alvarop/test_hub/hw/hub/test_hub.kicad_pcb

## KiCad design hw/hub/test_hub.kicad_pcb (2018-01-09)

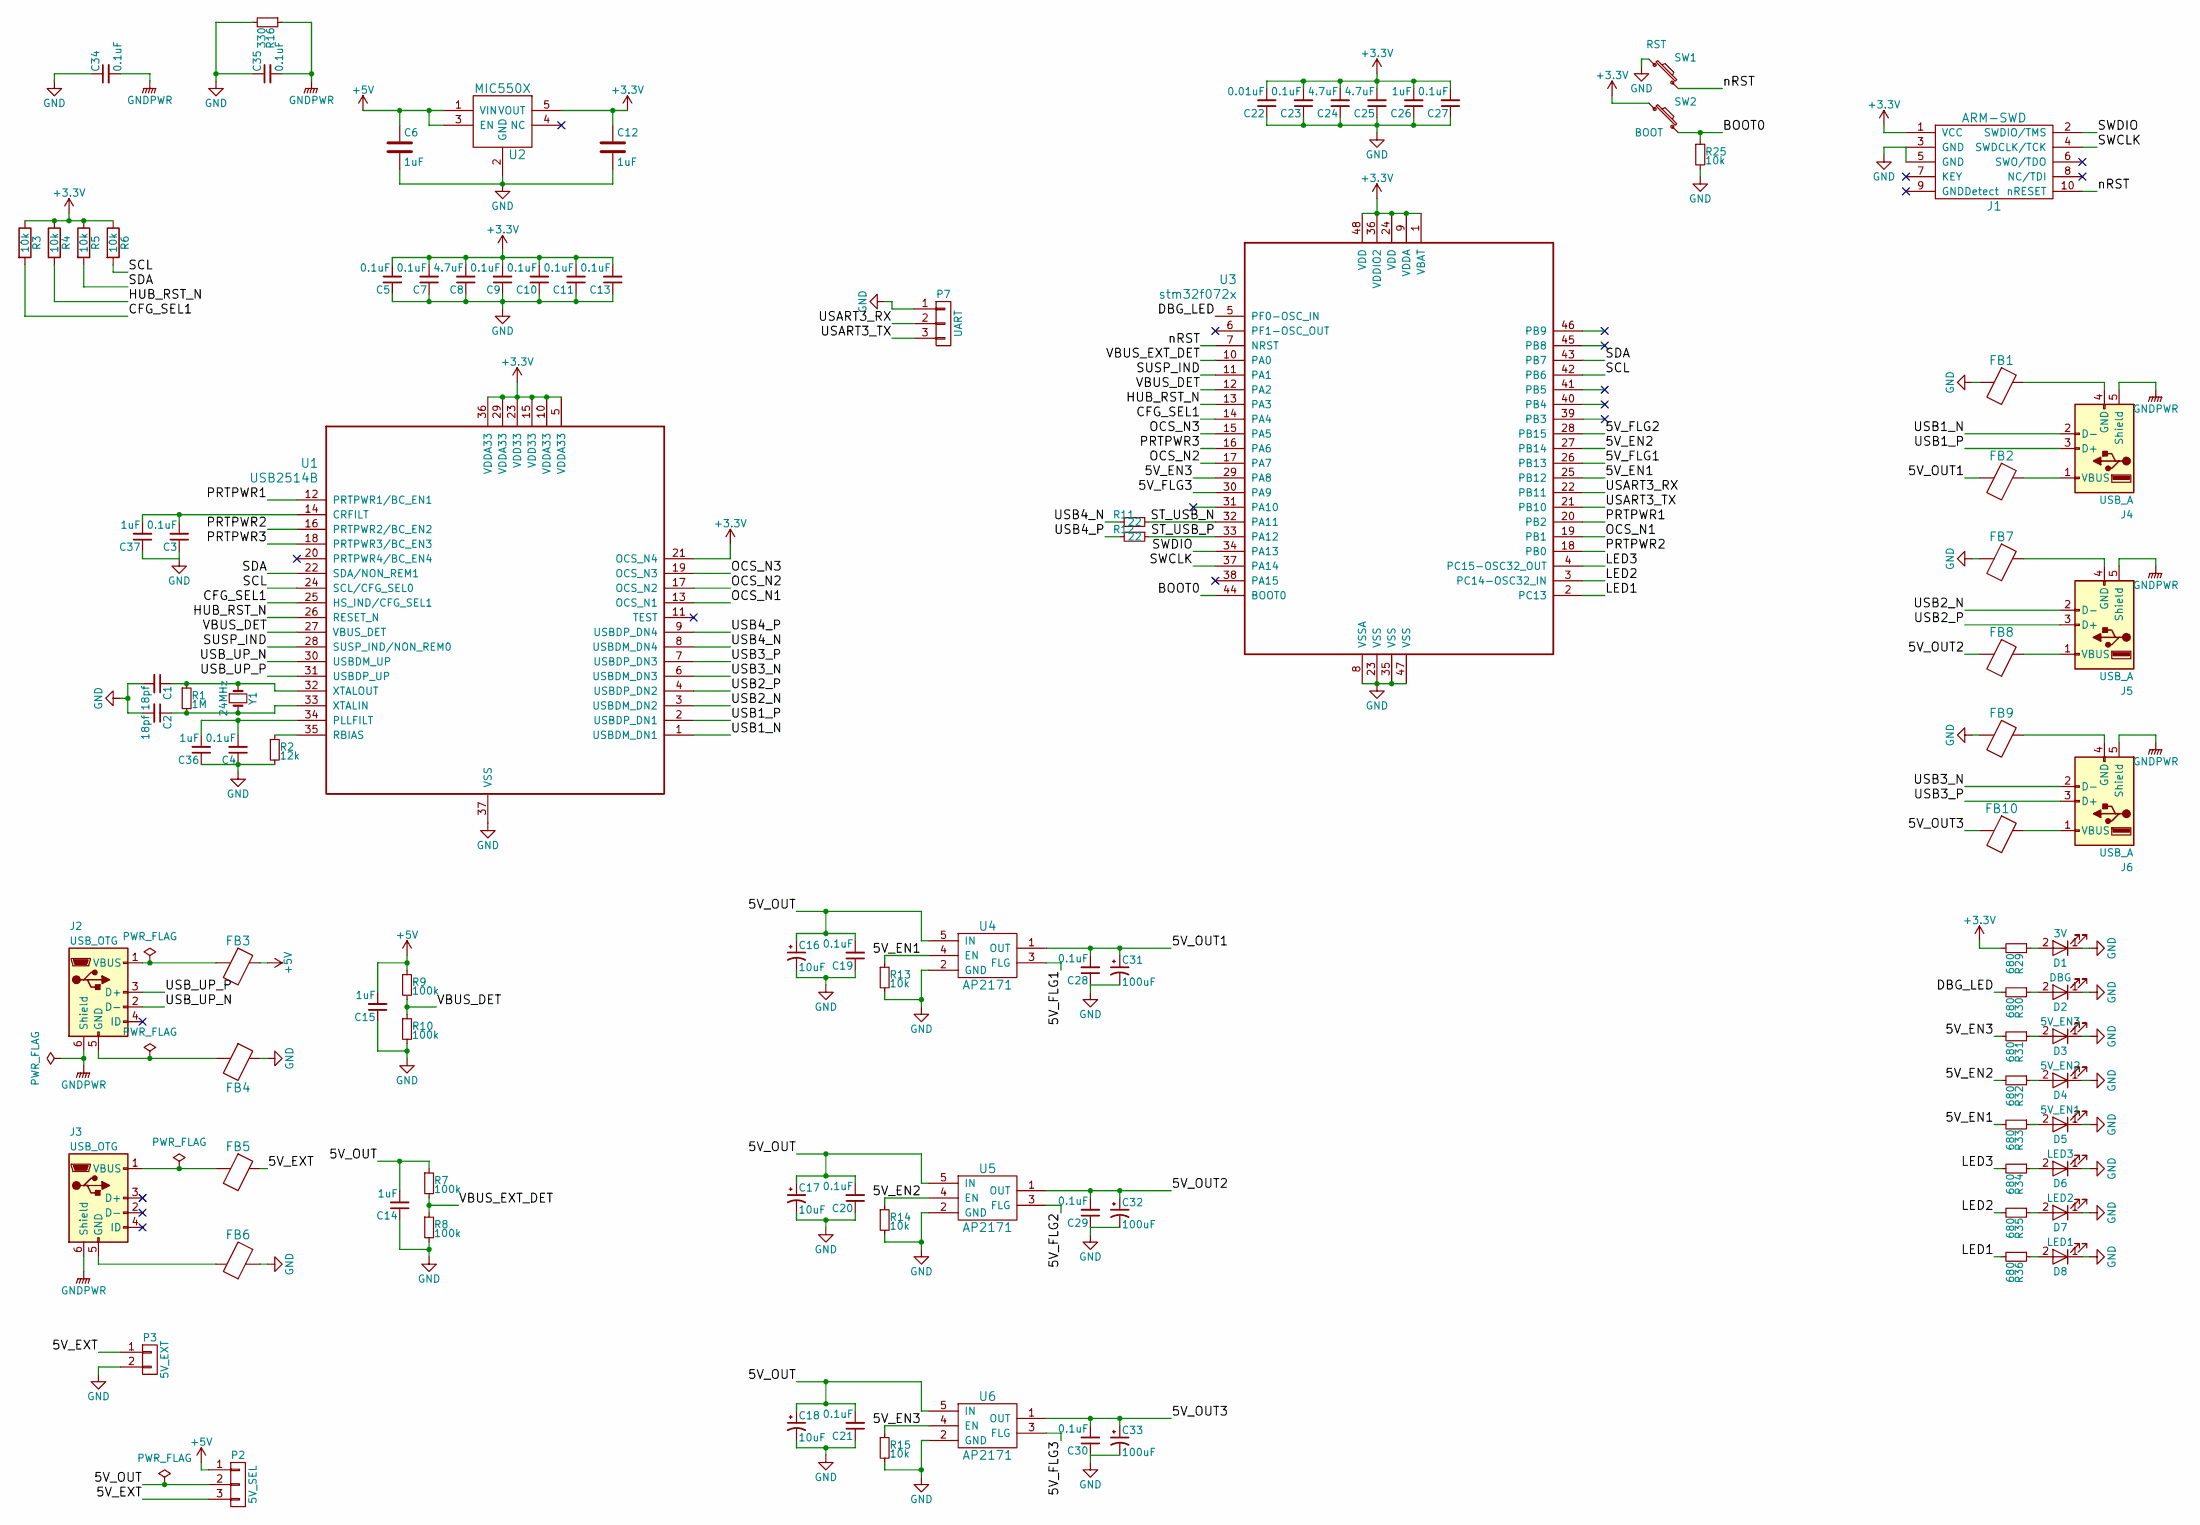
[picture p1: schematic test_hub.sch, Test Hub]

Parts:
C1, C2: 18pf; C_0603; MPN CL10C180JB8NNNC
C3, C4, C5, C7, C9, C10, C11, C13, C19, C20, C21, C23, C27, C28, C29, C30, C34, C35: 0.1uF; C_0603; MPN CC0603ZRY5V9BB104
C6, C12, C14, C15, C26, C36, C37: 1uF; C_0603; MPN GRM188R61C105KA93D
C8, C24, C25: 4.7uF; C_0603; MPN CL10B475KQ8NQNC
C16, C17, C18: 10uF; c_elec_4x5.3; MPN UWX1C100MCL1GB
C22: 0.01uF; C_0603; MPN CL21B103KBANNNC
C31, C32, C33: 100uF; c_elec_6.3x5.7; MPN UWR1A101MCL1GB
D1: 3V; LED_0805; MPN LG R971-KN-1
D2: DBG; LED_0805; MPN LG R971-KN-1
D3: 5V_EN3; LED_0805; MPN LG R971-KN-1
D4: 5V_EN2; LED_0805; MPN LG R971-KN-1
D5: 5V_EN1; LED_0805; MPN LG R971-KN-1
D6: LED3; LED_0805; MPN LG R971-KN-1
D7: LED2; LED_0805; MPN LG R971-KN-1
D8: LED1; LED_0805; MPN LG R971-KN-1
FB1, FB2, FB3, FB4, FB5, FB6, FB7, FB8, FB9, FB10: Ferrite_Bead; R_0603; MPN CIS10P221NC
J1: ARM-SWD; ARM_SWD_SMD; MPN 20021121-00010C4LF
J2, J3: USB_OTG; USB_MICRO_B; MPN 629105150521
J4, J5, J6: USB_A; 292303-1; MPN 292303-1
P2: 5V_SEL; Pin_Header_Straight_1x03
P3: 5V_EXT; Pin_Header_Straight_1x02
P7: UART; Pin_Header_Straight_1x03
R1: 1M; R_0603; MPN ERJ-3GEYJ105V
R2: 12k; R_0603; MPN ERJ-3EKF1202V
R3, R4, R5, R6, R13, R14, R15, R25: 10k; R_0603; MPN RC0603FR-0710KL
R7, R8, R9, R10: 100k; R_0603; MPN ERJ-3GEYJ104V
R11, R12: 22; R_0603; MPN RC0603FR-0722RL
R16: 330; R_0603; MPN RC0603JR-07330RL
R29, R30, R31, R32, R33, R34, R35, R36: 680; R_0603; MPN RC0603JR-07680RL
SW1: RST; PTS645SM43SMTR92; MPN PTS645SM43SMTR92
SW2: BOOT; PTS645SM43SMTR92; MPN PTS645SM43SMTR92
U1: USB2514B; SQFN36; MPN USB2514B/M2
U2: MIC550X; SOT-23(M5); MPN MIC5504-3.3YM5-TR
U3: stm32f072x; LQFP48; MPN STM32F072RBT6
U4, U5, U6: AP2171; SOT-25; MPN AP2171WG-7
Y1: 24MHz; HCM49; MPN HCM4924000000ABJT

Connections:
+3V3: C5.2, C7.2, C8.2, C9.2, C10.2, C11.2, C12.1, C13.2, C22.2, C23.2, C24.2, C25.2, C26.2, C27.2, J1.1 (VCC), R3.1, R4.1, R5.1, R6.1, R29.2, SW2.1, U1.5 (VDDA33), U1.10 (VDDA33), U1.15 (VDD33), U1.21 (OCS_N4), U1.23 (VDD33), U1.29 (VDDA33), U1.36 (VDDA33), U2.5 (VOUT), U3.1 (VBAT), U3.9 (VDDA), U3.24 (VDD), U3.36 (VDDIO2), U3.48 (VDD)
+5V: C6.1, C15.2, FB3.2, P2.1, R9.1, U2.1 (VIN), U2.3 (EN)
/5V_EN1: R13.1, R33.2, U3.25 (PB12), U4.4 (EN)
/5V_EN2: R14.1, R32.2, U3.27 (PB14), U5.4 (EN)
/5V_EN3: R15.1, R31.2, U3.29 (PA8), U6.4 (EN)
/5V_EXT: FB5.2, P2.3, P3.1
/5V_FLG1: U3.26 (PB13), U4.3 (FLG)
/5V_FLG2: U3.28 (PB15), U5.3 (FLG)
/5V_FLG3: U3.30 (PA9), U6.3 (FLG)
/5V_OUT: C14.2, C16.1, C17.1, C18.1, C19.2, C20.2, C21.2, P2.2, R7.1, U4.5 (IN), U5.5 (IN), U6.5 (IN)
/5V_OUT1: C28.2, C31.1, FB2.1, U4.1 (OUT)
/5V_OUT2: C29.2, C32.1, FB8.1, U5.1 (OUT)
/5V_OUT3: C30.2, C33.1, FB10.1, U6.1 (OUT)
/BOOT0: R25.1, SW2.2, U3.44 (BOOT0)
/CFG_SEL1: R3.2, U1.25 (HS_IND/CFG_SEL1), U3.14 (PA4)
/DBG_LED: R30.2, U3.5 (PF0-OSC_IN)
/HUB_RST_N: R4.2, U1.26 (RESET_N), U3.13 (PA3)
/LED1: R36.2, U3.2 (PC13)
/LED2: R35.2, U3.3 (PC14-OSC32_IN)
/LED3: R34.2, U3.4 (PC15-OSC32_OUT)
/OCS_N1: U1.13 (OCS_N1), U3.19 (PB1)
/OCS_N2: U1.17 (OCS_N2), U3.17 (PA7)
/OCS_N3: U1.19 (OCS_N3), U3.15 (PA5)
/PRTPWR1: U1.12 (PRTPWR1/BC_EN1), U3.20 (PB2)
/PRTPWR2: U1.16 (PRTPWR2/BC_EN2), U3.18 (PB0)
/PRTPWR3: U1.18 (PRTPWR3/BC_EN3), U3.16 (PA6)
/SCL: R6.2, U1.24 (SCL/CFG_SEL0), U3.42 (PB6)
/SDA: R5.2, U1.22 (SDA/NON_REM1), U3.43 (PB7)
/ST_USB_N: R11.1, U3.32 (PA11)
/ST_USB_P: R12.1, U3.33 (PA12)
/SUSP_IND: U1.28 (SUSP_IND/NON_REM0), U3.11 (PA1)
/SWCLK: J1.4 (SWDCLK/TCK), U3.37 (PA14)
/SWDIO: J1.2 (SWDIO/TMS), U3.34 (PA13)
/USART3_RX: P7.2, U3.22 (PB11)
/USART3_TX: P7.3, U3.21 (PB10)
/USB1_N: J4.2 (D-), U1.1 (USBDM_DN1)
/USB1_P: J4.3 (D+), U1.2 (USBDP_DN1)
/USB2_N: J5.2 (D-), U1.3 (USBDM_DN2)
/USB2_P: J5.3 (D+), U1.4 (USBDP_DN2)
/USB3_N: J6.2 (D-), U1.6 (USBDM_DN3)
/USB3_P: J6.3 (D+), U1.7 (USBDP_DN3)
/USB4_N: R11.2, U1.8 (USBDM_DN4)
/USB4_P: R12.2, U1.9 (USBDP_DN4)
/USB_UP_N: J2.2 (D-), U1.30 (USBDM_UP)
/USB_UP_P: J2.3 (D+), U1.31 (USBDP_UP)
/VBUS_DET: R9.2, R10.1, U1.27 (VBUS_DET), U3.12 (PA2)
/VBUS_EXT_DET: R7.2, R8.1, U3.10 (PA0)
/nRST: J1.10 (nRESET), SW1.2, U3.7 (NRST)
GND: C1.2, C2.2, C3.1, C4.1, C5.1, C6.2, C7.1, C8.1, C9.1, C10.1, C11.1, C12.2, C13.1, C14.1, C15.1, C16.2, C17.2, C18.2, C19.1, C20.1, C21.1, C22.1, C23.1, C24.1, C25.1, C26.1, C27.1, C28.1, C29.1, C30.1, C31.2, C32.2, C33.2, C34.1, C35.1, C36.1, C37.1, D1.1 (K), D2.1 (K), D3.1 (K), D4.1 (K), D5.1 (K), D6.1 (K), D7.1 (K), D8.1 (K), FB1.1, FB4.2, FB6.1, FB7.1, FB9.1, J1.3 (GND), J1.5 (GND), P3.2, P7.1, R2.2, R8.2, R10.2, R13.2, R14.2, R15.2, R16.2, R25.2, SW1.1, U1.37 (VSS), U2.2 (GND), U3.8 (VSSA), U3.23 (VSS), U3.35 (VSS), U3.47 (VSS), U4.2 (GND), U5.2 (GND), U6.2 (GND)
GNDPWR: C34.2, C35.2, J2.6 (Shield), J3.6 (Shield), J4.5 (Shield), J5.5 (Shield), J6.5 (Shield), R16.1
unnamed: C1.1, R1.1, U1.32 (XTALOUT), Y1.1
unnamed: C2.1, R1.2, U1.33 (XTALIN), Y1.2
unnamed: C3.2, C37.2, U1.14 (CRFILT)
unnamed: C4.2, C36.2, U1.34 (PLLFILT)
unnamed: D1.2 (A), R29.1
unnamed: D2.2 (A), R30.1
unnamed: D3.2 (A), R31.1
unnamed: D4.2 (A), R32.1
unnamed: D5.2 (A), R33.1
unnamed: D6.2 (A), R34.1
unnamed: D7.2 (A), R35.1
unnamed: D8.2 (A), R36.1
unnamed: FB1.2, J4.4 (GND)
unnamed: FB2.2, J4.1 (VBUS)
unnamed: FB3.1, J2.1 (VBUS)
unnamed: FB4.1, J2.5 (GND)
unnamed: FB5.1, J3.1 (VBUS)
unnamed: FB6.2, J3.5 (GND)
unnamed: FB7.2, J5.4 (GND)
unnamed: FB8.2, J5.1 (VBUS)
unnamed: FB9.2, J6.4 (GND)
unnamed: FB10.2, J6.1 (VBUS)
unnamed: R2.1, U1.35 (RBIAS)

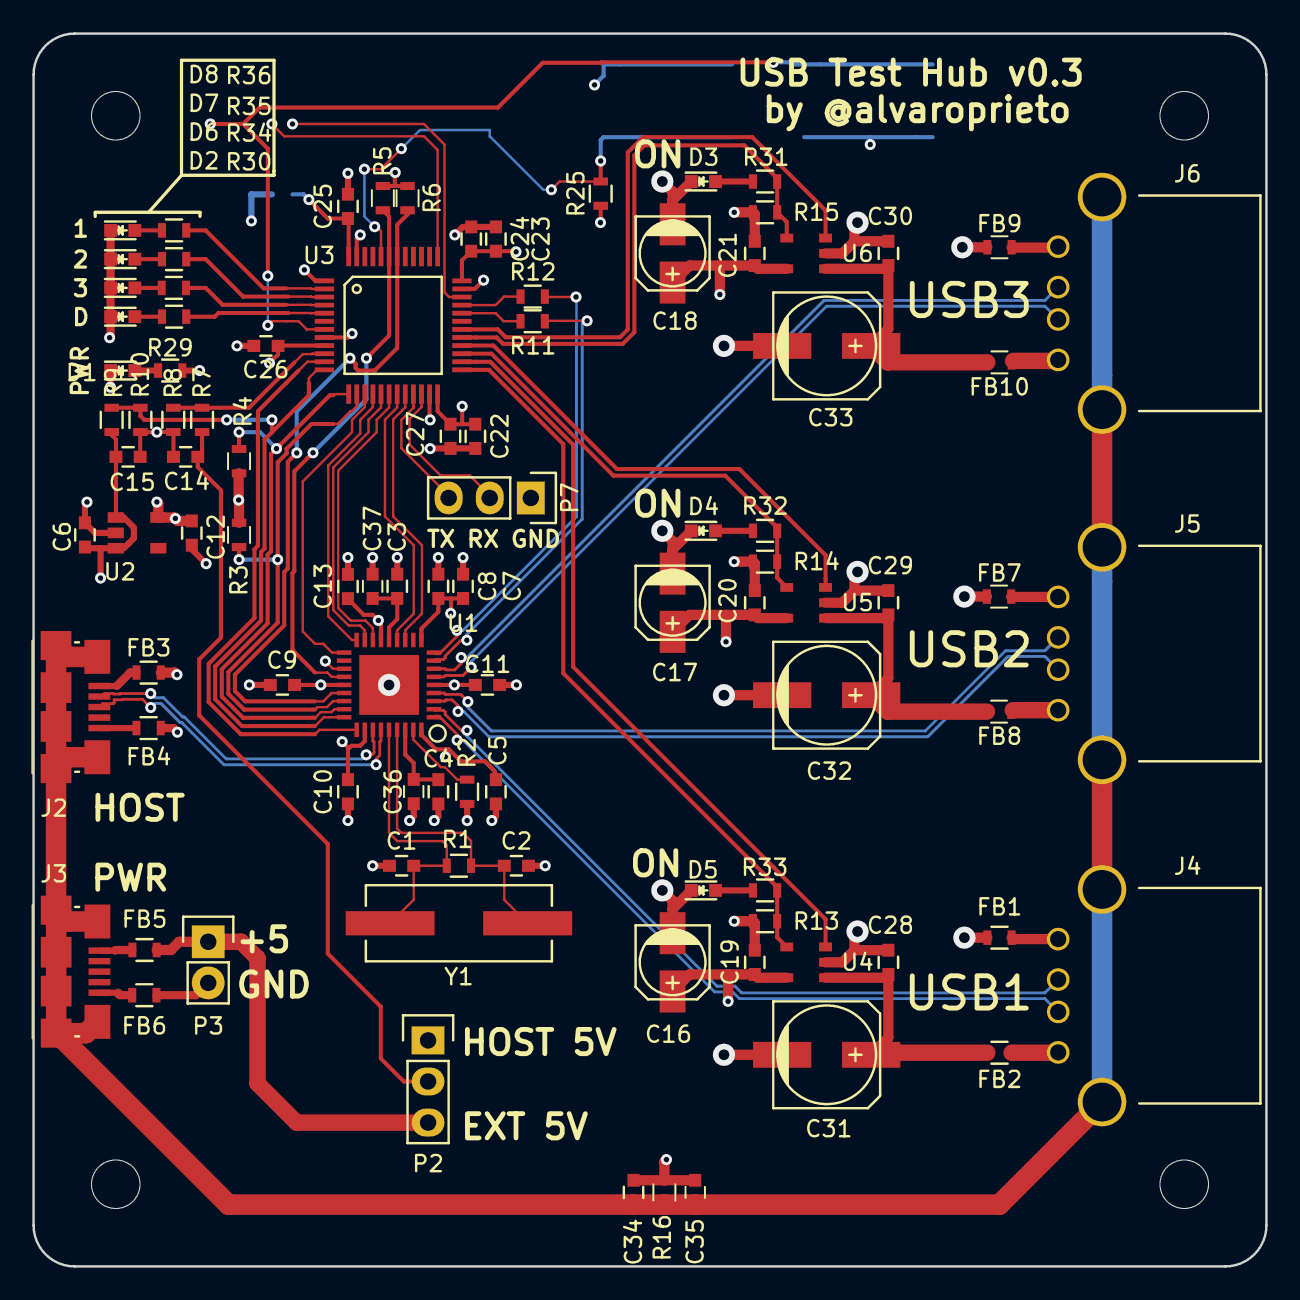
[picture p2: board test_hub.kicad_pcb from above]

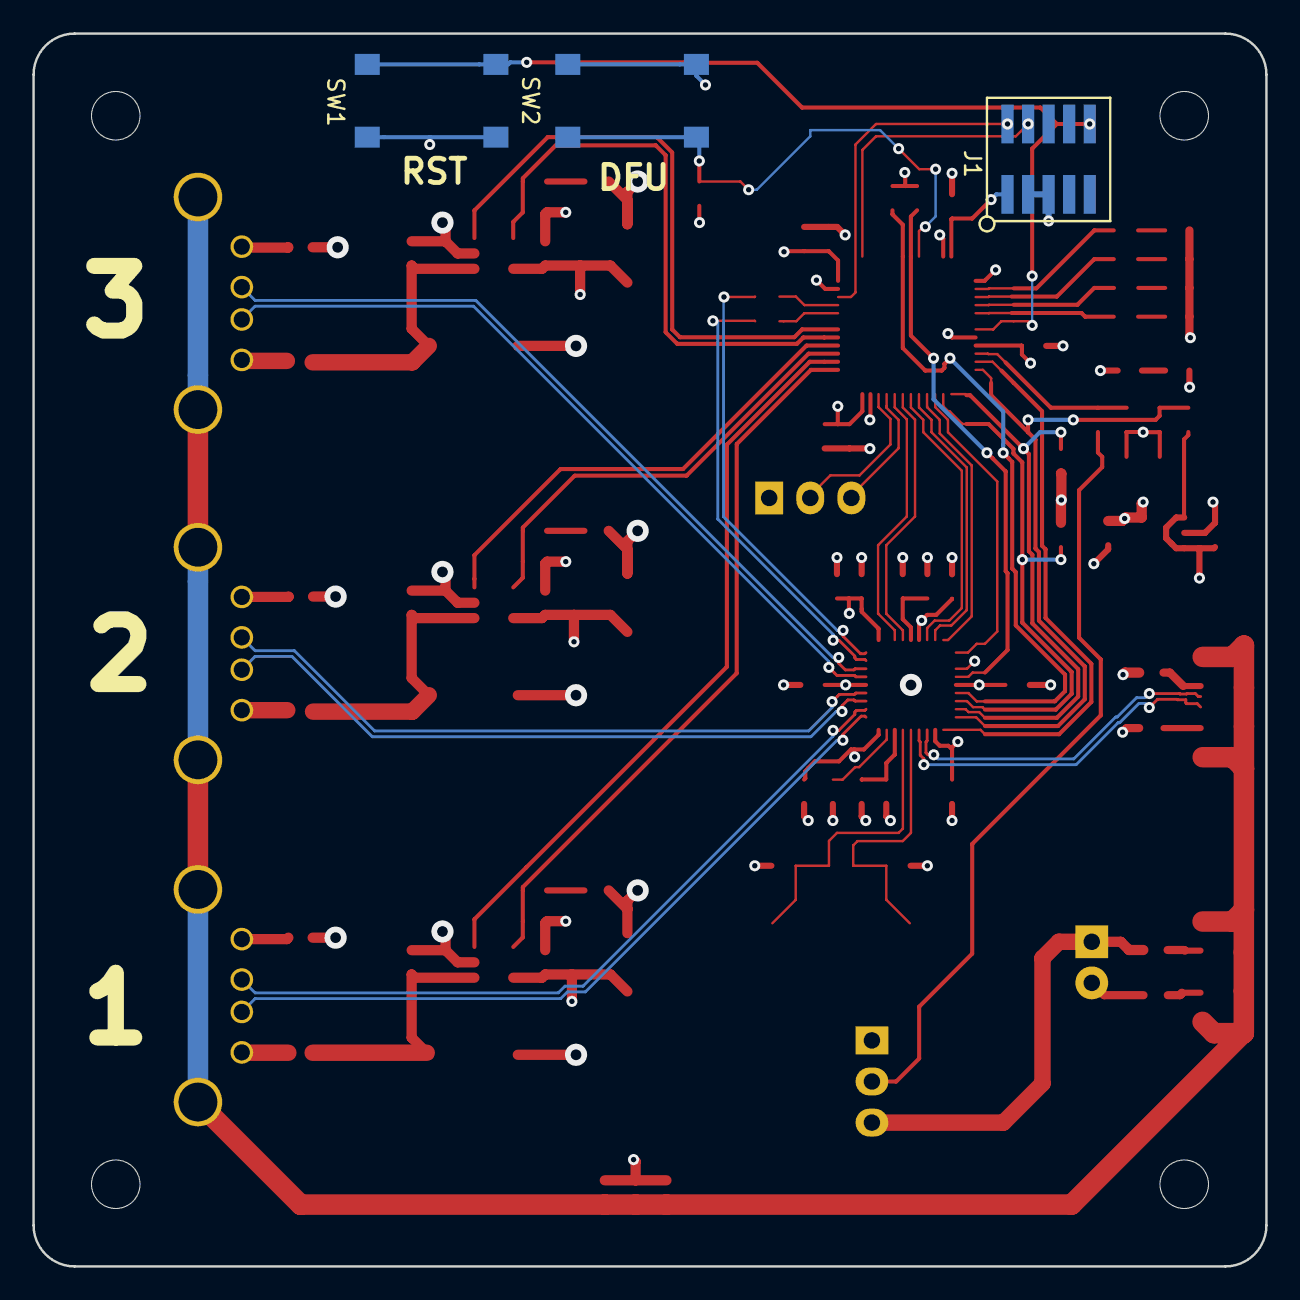
[picture p3: board test_hub.kicad_pcb from below]

Board: 4 copper layers, 76.2 x 76.2 mm, 98 parts (3 on the bottom side), 73 nets.
