alvarop/test_hub/hw/breakout/hub_breakout.kicad_pcb

## KiCad design hw/breakout/hub_breakout.kicad_pcb (2017-03-22)

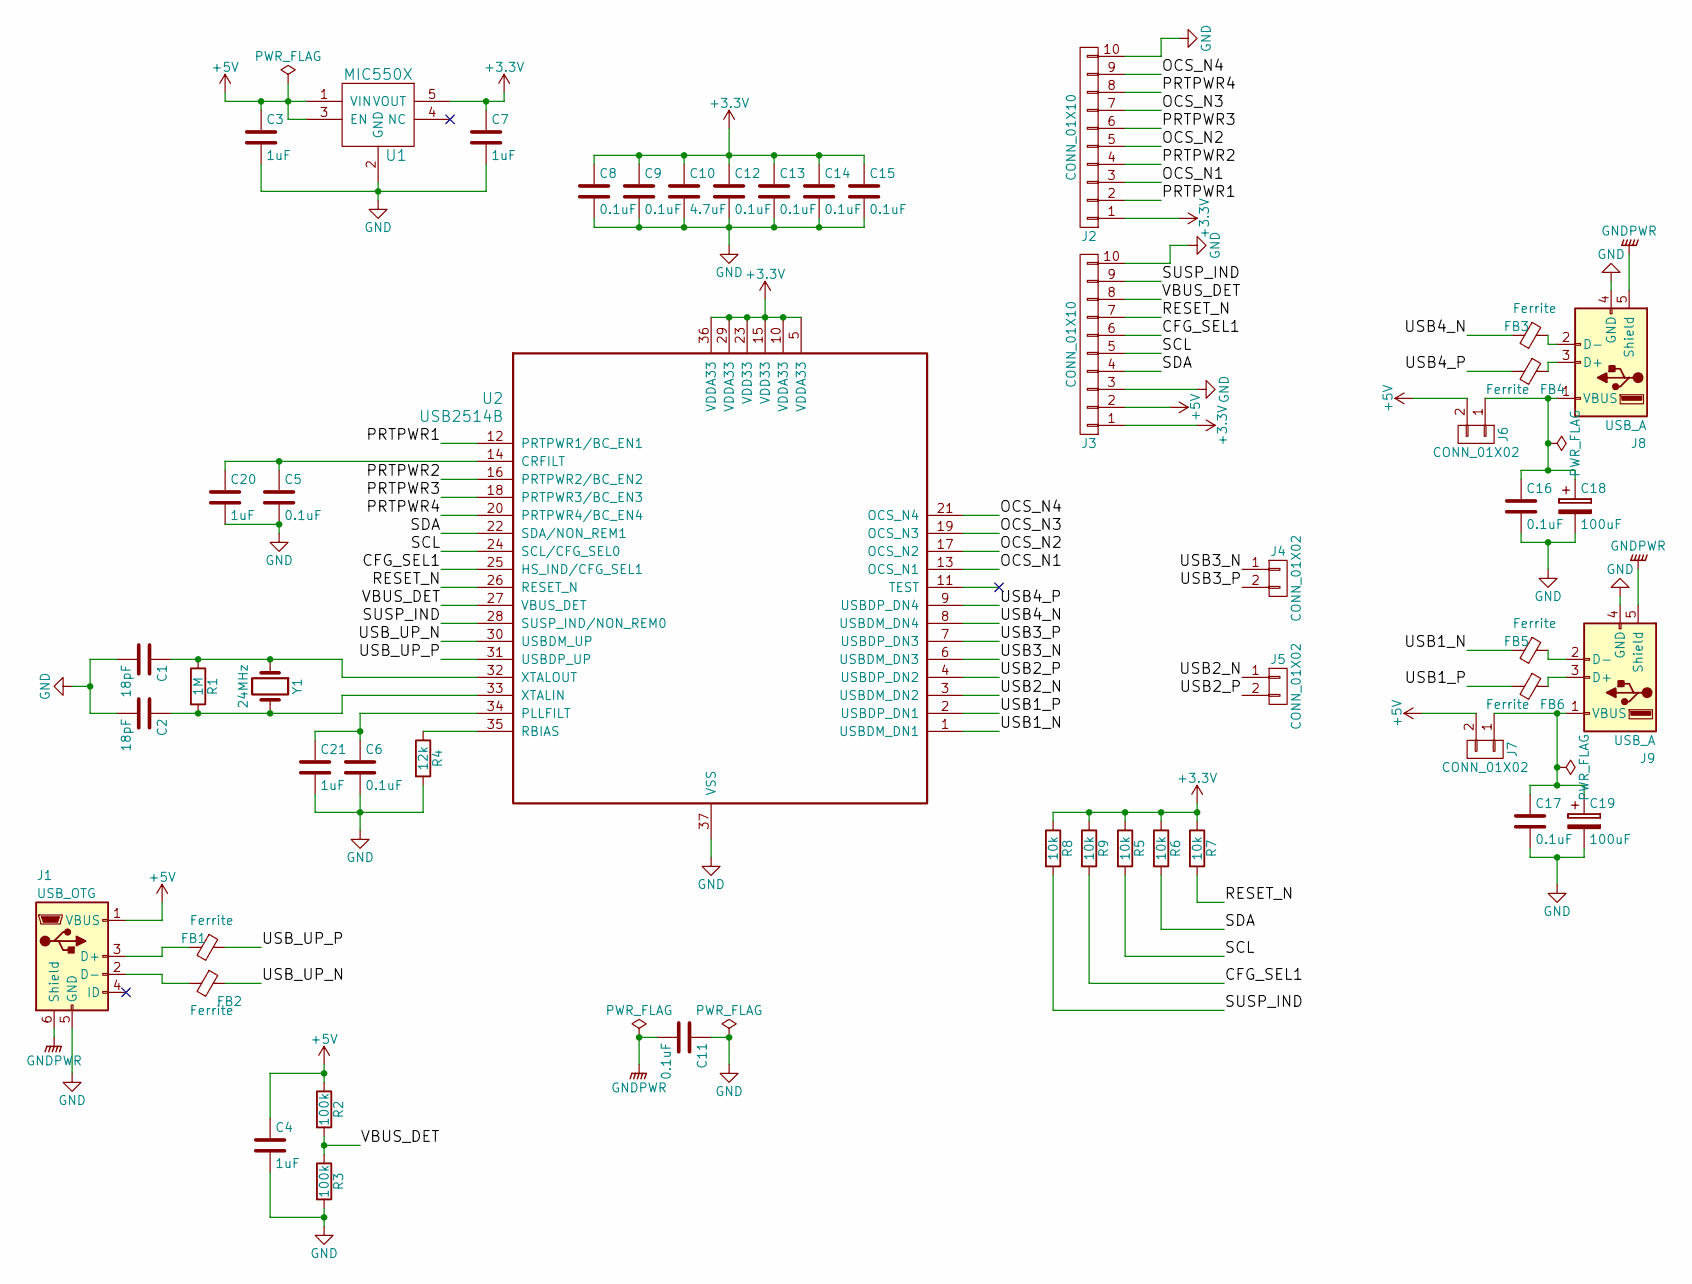
[picture p4: schematic hub_breakout.sch]

Parts:
C1, C2: 18pF; C_0603; MPN CL10C180JB8NNNC
C3, C4, C7, C20, C21: 1uF; C_0603; MPN GRM188R61C105KA93D
C5, C6, C8, C9, C11, C12, C13, C14, C15, C16, C17: 0.1uF; C_0603; MPN CC0603ZRY5V9BB104
C10: 4.7uF; C_0603; MPN CL10B475KQ8NQNC
C18, C19: 100uF; CP_Elec_6.3x5.7; MPN UWR1A101MCL1GB
FB1, FB2, FB3, FB4, FB5, FB6: Ferrite; R_0603; MPN BLM18EG221SN1D
J1: USB_OTG; USB_MICRO_B; MPN 10118193-0001LF
J2, J3: CONN_01X10; Pin_Header_Straight_1x10_Pitch2.54mm
J4, J5, J6, J7: CONN_01X02; Pin_Header_Straight_1x02_Pitch2.54mm
J8, J9: USB_A; 292303-1; MPN 292303-1
R1: 1M; R_0603; MPN ERJ-3GEYJ105V
R2, R3: 100k; R_0603; MPN ERJ-3GEYJ104V
R4: 12k; R_0603; MPN ERJ-3EKF1202V
R5, R6, R7, R8, R9: 10k; R_0603; MPN RC0603FR-0710KL
U1: MIC550X; SOT-23(M5); MPN MIC5504-3.3YM5-TR
U2: USB2514B; SQFN36; MPN USB2514B/M2
Y1: 24MHz; HCM49; MPN HCM4924000000ABJT

Connections:
+3V3: C7.1, C8.1, C9.1, C10.1, C12.1, C13.1, C14.1, C15.1, J2.1, J3.1, R5.1, R6.1, R7.1, R8.1, R9.1, U1.5 (VOUT), U2.5 (VDDA33), U2.10 (VDDA33), U2.15 (VDD33), U2.23 (VDD33), U2.29 (VDDA33), U2.36 (VDDA33)
+5V: C3.1, C4.1, J1.1 (VBUS), J3.2, J6.2, J7.2, R2.1, U1.1 (VIN), U1.3 (EN)
/CFG_SEL1: J3.6, R9.2, U2.25 (HS_IND/CFG_SEL1)
/OCS_N1: J2.3, U2.13 (OCS_N1)
/OCS_N2: J2.5, U2.17 (OCS_N2)
/OCS_N3: J2.7, U2.19 (OCS_N3)
/OCS_N4: J2.9, U2.21 (OCS_N4)
/PRTPWR1: J2.2, U2.12 (PRTPWR1/BC_EN1)
/PRTPWR2: J2.4, U2.16 (PRTPWR2/BC_EN2)
/PRTPWR3: J2.6, U2.18 (PRTPWR3/BC_EN3)
/PRTPWR4: J2.8, U2.20 (PRTPWR4/BC_EN4)
/RESET_N: J3.7, R7.2, U2.26 (RESET_N)
/SCL: J3.5, R5.2, U2.24 (SCL/CFG_SEL0)
/SDA: J3.4, R6.2, U2.22 (SDA/NON_REM1)
/SUSP_IND: J3.9, R8.2, U2.28 (SUSP_IND/NON_REM0)
/USB1_N: FB5.2, U2.1 (USBDM_DN1)
/USB1_P: FB6.2, U2.2 (USBDP_DN1)
/USB2_N: J5.1, U2.3 (USBDM_DN2)
/USB2_P: J5.2, U2.4 (USBDP_DN2)
/USB3_N: J4.1, U2.6 (USBDM_DN3)
/USB3_P: J4.2, U2.7 (USBDP_DN3)
/USB4_N: FB3.2, U2.8 (USBDM_DN4)
/USB4_P: FB4.2, U2.9 (USBDP_DN4)
/USB_UP_N: FB2.1, U2.30 (USBDM_UP)
/USB_UP_P: FB1.1, U2.31 (USBDP_UP)
/VBUS_DET: J3.8, R2.2, R3.1, U2.27 (VBUS_DET)
GND: C1.2, C2.2, C3.2, C4.2, C5.2, C6.2, C7.2, C8.2, C9.2, C10.2, C11.1, C12.2, C13.2, C14.2, C15.2, C16.2, C17.2, C18.2, C19.2, C20.2, C21.2, J1.5 (GND), J2.10, J3.3, J3.10, J8.4 (GND), J9.4 (GND), R3.2, R4.2, U1.2 (GND), U2.37 (VSS)
GNDPWR: C11.2, J1.6 (Shield), J8.5 (Shield), J9.5 (Shield)
unnamed: C1.1, R1.1, U2.32 (XTALOUT), Y1.1
unnamed: C2.1, R1.2, U2.33 (XTALIN), Y1.2
unnamed: C16.1, C18.1, J6.1, J8.1 (VBUS)
unnamed: C17.1, C19.1, J7.1, J9.1 (VBUS)
unnamed: C5.1, C20.1, U2.14 (CRFILT)
unnamed: C6.1, C21.1, U2.34 (PLLFILT)
unnamed: FB1.2, J1.3 (D+)
unnamed: FB2.2, J1.2 (D-)
unnamed: FB3.1, J8.2 (D-)
unnamed: FB4.1, J8.3 (D+)
unnamed: FB5.1, J9.2 (D-)
unnamed: FB6.1, J9.3 (D+)
unnamed: R4.1, U2.35 (RBIAS)

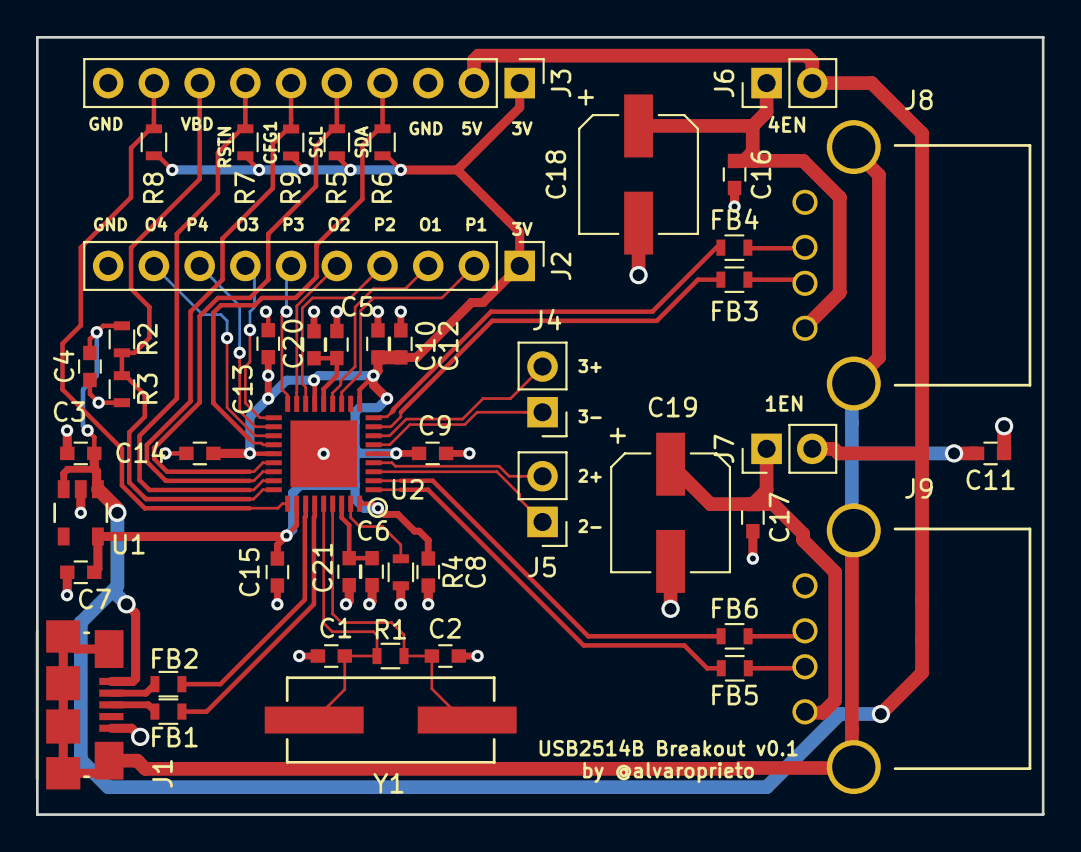
[picture p5: board hub_breakout.kicad_pcb from above]

Board: 2 copper layers, 55.9 x 43.2 mm, 48 parts (0 on the bottom side), 41 nets.
