alvarop/test_hub/fw/board.h

#ifndef __PINS_H__
#define __PINS_H__

#define _LED1_PORT GPIOC
#define _LED1_PIN 13

#define _LED2_PORT GPIOC
#define _LED2_PIN 14

#define _LED3_PORT GPIOC
#define _LED3_PIN 15

#define _DBG_LED_PORT GPIOF
#define _DBG_LED_PIN 0

#define _VBUS_EXT_DET_PORT GPIOA
#define _VBUS_EXT_DET_PIN 1

#define _SUSP_IND_PORT GPIOB
#define _SUSP_IND_PIN 3

#define _VBUS_DET_PORT GPIOA
#define _VBUS_DET_PIN 0

#define _HUB_RST_N_PORT GPIOB
#define _HUB_RST_N_PIN 15

#define _CFG_SEL1_PORT GPIOB
#define _CFG_SEL1_PIN 4

#define _OCS_N3_PORT GPIOA
#define _OCS_N3_PIN 5

#define _PRTPWR3_PORT GPIOA
#define _PRTPWR3_PIN 6

#define _OCS_N2_PORT GPIOA
#define _OCS_N2_PIN 7

#define _PRTPWR2_PORT GPIOB
#define _PRTPWR2_PIN 0

#define _OCS_N1_PORT GPIOB
#define _OCS_N1_PIN 1

#define _PRTPWR1_PORT GPIOB
#define _PRTPWR1_PIN 2

#define _USART3_TX_PORT GPIOB
#define _USART3_TX_PIN 10

#define _USART3_RX_PORT GPIOB
#define _USART3_RX_PIN 11

#define _5V_EN1_PORT GPIOB
#define _5V_EN1_PIN 12

#define _5V_FLG1_PORT GPIOA
#define _5V_FLG1_PIN 8

#define _5V_EN2_PORT GPIOB
#define _5V_EN2_PIN 13

#define _5V_FLG2_PORT GPIOA
#define _5V_FLG2_PIN 9

#define _5V_EN3_PORT GPIOB
#define _5V_EN3_PIN 14

#define _5V_FLG3_PORT GPIOA
#define _5V_FLG3_PIN 10

#define _ST_USB_N_PORT GPIOA
#define _ST_USB_N_PIN 11

#define _ST_USB_P_PORT GPIOA
#define _ST_USB_P_PIN 12

#define _SWDIO_PORT GPIOA
#define _SWDIO_PIN 13

#define _SWCLK_PORT GPIOA
#define _SWCLK_PIN 14

#define _SCL_PORT GPIOB
#define _SCL_PIN 6

#define _SDA_PORT GPIOB
#define _SDA_PIN 7

#define _SNS1_PORT GPIOA
#define _SNS1_PIN 2

#define _SNS2_PORT GPIOA
#define _SNS2_PIN 3

#define _SNS3_PORT GPIOA
#define _SNS3_PIN 4

#endif  // __PINS_H__

// #ifndef __PINS_H__
// #define __PINS_H__

// #define _LED1_PORT GPIOC
// #define _LED1_PIN 13

// #define _LED2_PORT GPIOC
// #define _LED2_PIN 14

// #define _LED3_PORT GPIOC
// #define _LED3_PIN 15

// #define _DBG_LED_PORT GPIOF
// #define _DBG_LED_PIN 0

// #define _VBUS_EXT_DET_PORT GPIOA
// #define _VBUS_EXT_DET_PIN 0

// #define _SUSP_IND_PORT GPIOA
// #define _SUSP_IND_PIN 1

// #define _VBUS_DET_PORT GPIOA
// #define _VBUS_DET_PIN 2

// #define _HUB_RST_N_PORT GPIOA
// #define _HUB_RST_N_PIN 3

// #define _CFG_SEL1_PORT GPIOA
// #define _CFG_SEL1_PIN 4

// #define _OCS_N3_PORT GPIOA
// #define _OCS_N3_PIN 5

// #define _PRTPWR3_PORT GPIOA
// #define _PRTPWR3_PIN 6

// #define _OCS_N2_PORT GPIOA
// #define _OCS_N2_PIN 7

// #define _PRTPWR2_PORT GPIOB
// #define _PRTPWR2_PIN 0

// #define _OCS_N1_PORT GPIOB
// #define _OCS_N1_PIN 1

// #define _PRTPWR1_PORT GPIOB
// #define _PRTPWR1_PIN 2

// #define _USART3_TX_PORT GPIOB
// #define _USART3_TX_PIN 10

// #define _USART3_RX_PORT GPIOB
// #define _USART3_RX_PIN 11

// #define _5V_EN1_PORT GPIOB
// #define _5V_EN1_PIN 12

// #define _5V_FLG1_PORT GPIOB
// #define _5V_FLG1_PIN 13

// #define _5V_EN2_PORT GPIOB
// #define _5V_EN2_PIN 14

// #define _5V_FLG2_PORT GPIOB
// #define _5V_FLG2_PIN 15

// #define _5V_EN3_PORT GPIOA
// #define _5V_EN3_PIN 8

// #define _5V_FLG3_PORT GPIOA
// #define _5V_FLG3_PIN 9

// #define _ST_USB_N_PORT GPIOA
// #define _ST_USB_N_PIN 11

// #define _ST_USB_P_PORT GPIOA
// #define _ST_USB_P_PIN 12

// #define _SWDIO_PORT GPIOA
// #define _SWDIO_PIN 13

// #define _SWCLK_PORT GPIOA
// #define _SWCLK_PIN 14

// #define _SCL_PORT GPIOB
// #define _SCL_PIN 6

// #define _SDA_PORT GPIOB
// #define _SDA_PIN 7

// #endif  // __PINS_H__
