alvarop/test_hub/fw/usb2514b_config.c

#include <stdint.h>

// TODO - put in ram so we can modify it later on the go
const uint8_t hub_cfg[256] = {
    0x24,  // Vendor ID LSB
    0x04,  // Vendor ID MSB
    0x14,  // Product ID LSB
    0x25,  // Product ID MSB
    0xB3,  // Device ID LSB
    0x0B,  // Device ID MSB
    0x9B,  // Configuration Data Byte 1
    0x20,  // Configuration Data Byte 2
    0x02,  // Configuration Data Byte 3
    0x00,  // Non-Removable Devices
    0x00,  // Port Disable (Self)
    0x00,  // Port Disable (Bus)
    0x01,  // Max Power (Self)
    0x32,  // Max Power (Bus)
    0x01,  // Hub Controller Max Current (Self)
    0x32,  // Hub Controller Max Current (Bus)
    0x32,  // Power-on Time
    0x00,  // Language ID High
    0x00,  // Language ID Low
    0x00,  // Manufacturer String Length
    0x00,  // Product String Length
    0x00,  // Serial String Length
    0x00,  // Manufacturer String
    0x00,  //
    0x00,  //
    0x00,  //
    0x00,  //
    0x00,  //
    0x00,  //
    0x00,  //
    0x00,  //
    0x00,  //
    0x00,  //
    0x00,  //
    0x00,  //
    0x00,  //
    0x00,  //
    0x00,  //
    0x00,  //
    0x00,  //
    0x00,  //
    0x00,  //
    0x00,  //
    0x00,  //
    0x00,  //
    0x00,  //
    0x00,  //
    0x00,  //
    0x00,  //
    0x00,  //
    0x00,  //
    0x00,  //
    0x00,  //
    0x00,  //
    0x00,  //
    0x00,  //
    0x00,  //
    0x00,  //
    0x00,  //
    0x00,  //
    0x00,  //
    0x00,  //
    0x00,  //
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
    0x00,  // Product String
    0x00,  //
    0x00,  //
    0x00,  //
    0x00,  //
    0x00,  //
    0x00,  //
    0x00,  //
    0x00,  //
    0x00,  //
    0x00,  //
    0x00,  //
    0x00,  //
    0x00,  //
    0x00,  //
    0x00,  //
    0x00,  //
    0x00,  //
    0x00,  //
    0x00,  //
    0x00,  //
    0x00,  //
    0x00,  //
    0x00,  //
    0x00,  //
    0x00,  //
    0x00,  //
    0x00,  //
    0x00,  //
    0x00,  //
    0x00,  //
    0x00,  //
    0x00,  //
    0x00,  //
    0x00,  //
    0x00,  //
    0x00,  //
    0x00,  //
    0x00,  //
    0x00,  //
    0x00,  //
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
    0x00,  // Serial String
    0x00,  //
    0x00,  //
    0x00,  //
    0x00,  //
    0x00,  //
    0x00,  //
    0x00,  //
    0x00,  //
    0x00,  //
    0x00,  //
    0x00,  //
    0x00,  //
    0x00,  //
    0x00,  //
    0x00,  //
    0x00,  //
    0x00,  //
    0x00,  //
    0x00,  //
    0x00,  //
    0x00,  //
    0x00,  //
    0x00,  //
    0x00,  //
    0x00,  //
    0x00,  //
    0x00,  //
    0x00,  //
    0x00,  //
    0x00,  //
    0x00,  //
    0x00,  //
    0x00,  //
    0x00,  //
    0x00,  //
    0x00,  //
    0x00,  //
    0x00,  //
    0x00,  //
    0x00,  //
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
    0x00,  // Battery Charging Enable
    0x00,  //
    0x00,  //
    0x00,  //
    0x00,  //
    0x00,  //
    0x00,  //
    0x00,  //
    0x00,  //
    0x00,  //
    0x00,  //
    0x00,  //
    0x00,  //
    0x00,  //
    0x00,  //
    0x00,  //
    0x00,  // rsvd
    0x00,  //
    0x00,  //
    0x00,  //
    0x00,  //
    0x00,  //
    0x00,  //
    0x00,  //
    0x00,  //
    0x00,  //
    0x00,  //
    0x00,  //
    0x00,  //
    0x00,  //
    0x00,  //
    0x00,  //
    0x00,  //
    0x00,  //
    0x00,  //
    0x00,  //
    0x00,  //
    0x00,  // rsvd
    0x00,  // Boost_Up
    0x00,  // rsvd
    0x00,  // Boost_x:0
    0x00,  // rsvd
    0x00,  // Port Swap
    0x00,  // Port Map 12
    0x00,  // Port Map 34
    0x00,  // rsvd
    0x00,  // rsvd
    0x01,  // Status/Command
};
