alvarop/test_hub/fw/i2c.h

#ifndef __I2C_H__
#define __I2C_H__

#include <stdint.h>
#include "stm32f0xx.h"

typedef enum {
  I2C_OK = 0,
  I2C_ANACK = -1,
  I2C_DNACK = -2,
  I2C_TIMEOUT = -3,
  I2C_ERR = -9,
} i2cReturn_t;

void i2cSetup(uint32_t speed);
int32_t i2c(I2C_TypeDef *I2Cx, uint8_t addr, uint16_t wLen, uint8_t *wBuff,
            uint16_t rLen, uint8_t *rBuff);

#endif
