alvarop/test_hub/(commit log)

2017-02-11 Starting work on test_hub schematic
    [test_hub.kicad_pcb, test_hub.sch]
2017-02-11 First draft of schematic
    [test_hub.sch]
2017-02-12 Schematic and footprint assignments done
    [test_hub.sch]
2017-02-12 Start working on PCB...
    [test_hub.kicad_pcb]
2017-02-12 Fixed schematic bugs and added SWD/UART
    [test_hub.sch]
2017-02-13 PCB routing done (I think)
    [test_hub.kicad_pcb, test_hub.sch]
2017-02-14 Forgot to connect some things...
    [test_hub.kicad_pcb]
2017-02-14 Updated MPN's
    [test_hub.sch]
2017-02-15 Minor changes after exporting gerbers
    [test_hub.kicad_pcb]
2017-02-19 Kicad version update changes
    [test_hub.sch]
2017-02-19 Adding label for ST usb wires
    [test_hub.sch]
2017-03-16 Added board file (first test with new board!)
2017-03-16 Port power enable/disable working!
2017-03-21 Moving test_hub files under hub/ directory
    [test_hub.kicad_pcb, test_hub.sch]
2017-03-22 Adding usb2514b breakout
    Because I can't get test_hub working...
    [hub_breakout.kicad_pcb, hub_breakout.sch]
2017-03-28 Adding BOM for breakout
    [hub_breakout-BOM.csv, hub_breakout.sch]
2017-04-22 Fixing unconnected pads....
    Not sure how I missed so many unconnected things :(
    MAKE SURE YOU CLICK ON "LIST UNCONNECTED" AFTER RUNNING DRC!!!!!!!!!!!
    [test_hub.kicad_pcb]
2017-04-22 Hub is now working!!!!!!!!!!!!!!!!!
    Configured over i2c :D :D :D
2017-05-10 Move hub files to hw directory
    [test_hub.kicad_pcb, test_hub.sch]
2017-05-10 Split into hub and sense_hub
    [sense_hub.kicad_pcb, sense_hub.sch]
2017-05-10 Begin removing sense resistors from hub
    [test_hub.sch]
2017-05-10 Breakout should also be in hw directory
    [hub_breakout-BOM.csv, hub_breakout.kicad_pcb, hub_breakout.sch]
2017-05-13 Update test_hub
    No more rescued components
    Ripped up all traces
    Starting layout again
    [test_hub.kicad_pcb, test_hub.sch]
2017-05-14 More test_hub work
    [test_hub.kicad_pcb, test_hub.sch]
2017-05-19 Continued routing work on test_hub
    [test_hub.kicad_pcb, test_hub.sch]
2017-05-25 Almost done with test_hub layout
    [test_hub.kicad_pcb, test_hub.sch]
2017-05-25 All connections made!
    Now I just need to fix the USB clearances...
    [test_hub.kicad_pcb]
2017-05-25 Layout done!
    [test_hub.kicad_pcb]
2017-05-26 Cleaned up silkscreen
    [test_hub.kicad_pcb]
2017-06-11 Now working with test hub v0.2 with uart
2017-06-16 Serial terminal ove rUSB finally working :D :D :D :D
    Can't print before USB is initialized of course...
    Printing to stderr doesn't seem to be entirely working though :(
    [main.c, uart.c, usb2514b.c]
2017-08-20 Fixed stderr printing!
    Apparently _write() needs to return a valid value... who knew!
    [main.c, uart.c]
2017-09-14 Get rid of old ADC stuff
2018-01-09 Testing 4 layer PCB!
    Released v0.3 to JLPCB
    [test_hub.kicad_pcb]
2018-05-28 Adding hub config generator
    [hub_cfg.csv]
2018-05-28 Adding old adc files
